fifoclock/hardware/README.md

# FIFO Hardware
KiCAD Schematics, Footprints, PCB files, and LCSC BOM.

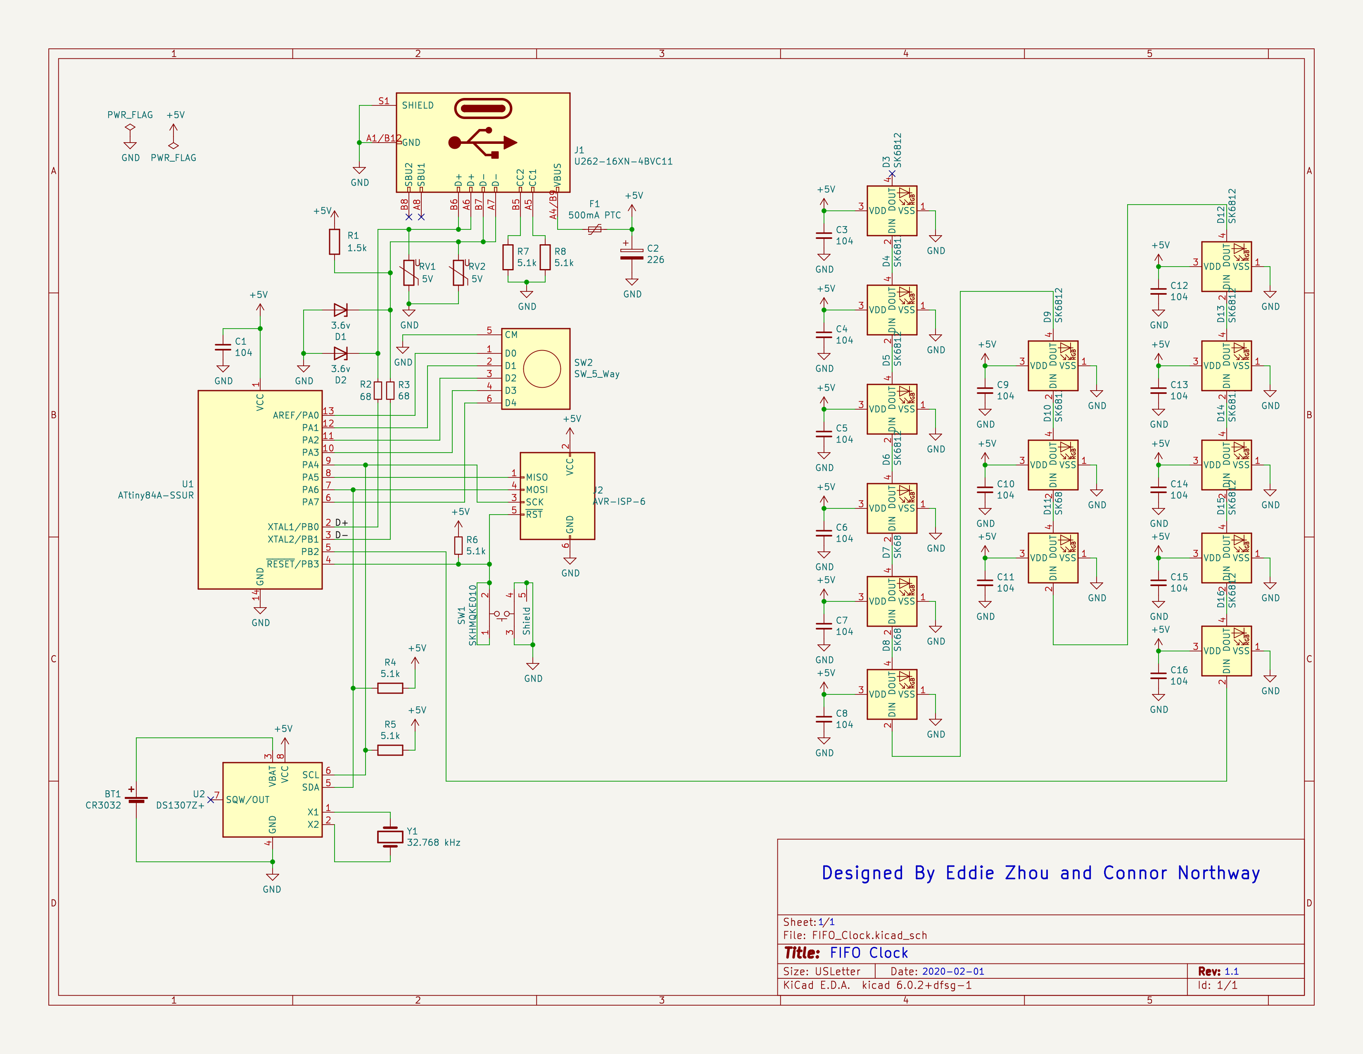
[picture p1: fifo-sch.png]
Preview of Schematic
