fifoclock/hardware/LCSC_BOM.xlsx

LCSC Part Number | Manufacture Part Number | Manufacturer | Customer NO. | Package | Description | RoHS | Order Qty. | Min\Mult Order Qty. | Unit Price | Order Price
C1590 | CL10B104KA8NNNC | Samsung Electro-Mechanics |  | 0603 | Multilayer Ceramic Capacitors MLCC - SMD/SMT 100nF 25V 0603 RoHS | Yes | 200 | 50\50 | $0.0058 | $1.16
C22843 | 0603WAF1501T5E | Uniroyal Elec |  | 0603 | Chip Resistor - Surface Mount 1.5KOhms ±1% 1/10W 0603 RoHS | Yes | 100 | 100\100 | $0.0011 | $0.11
C26000 | 0603WAJ0512T5E | Uniroyal Elec |  | 0603 | Chip Resistor - Surface Mount 5.1KOhms ±5% 1/10W 0603 RoHS | Yes | 100 | 100\100 | $0.0008 | $0.08
C26858 | DS1307ZN+T&R | Maxim Integrated |  | SOP-8_150mil | Real-time Clocks Clock/Calendar I2C, 2-Wire Serial 200uA @ 5V SOP-8_150mil RoHS | Yes | 10 | 1\1 | $0.4423 | $4.43
C27592 | 0603WAF680JT5E | Uniroyal Elec |  | 0603 | Chip Resistor - Surface Mount 68Ohms ±1% 1/10W 0603 RoHS | Yes | 100 | 100\100 | $0.0011 | $0.11
C70376 | BS-2-1 | Q&J |  | DIP | Battery Holders, Clips & Contacts DIP RoHS | Yes | 10 | 10\10 | $0.0573 | $0.58
C92594 | K1-5203UA-01 | Korean Hroparts Elec |  | 7.5mm*7.5mm | 5-way Tactile Switches 7.5mm*7.5mm RoHS | Yes | 10 | 1\1 | $0.3357 | $3.36
C128458 | EEEFK1H220P | PANASONIC |  | SMD,6.3x5.8mm | Aluminum Electrolytic Capacitors - SMD 22uF ±20% 50V SMD,6.3x5.8mm RoHS | Yes | 10 | 5\5 | $0.1050 | $1.05
C202416 | SKHMQKE010 | ALPS Electric |  | SMD | Tactile Switches SPST-NO 6.50mm x 6.20mm 3.10mm 50mA @ 12VDC SMD RoHS | Yes | 10 | 1\1 | $0.1861 | $1.87
C213419 | 1TD125BFNS001 | KDS Daishinku |  | Cylindrical plug2x6 | Radial Cylinder Crystals 32.768KHz ±10ppm Cylindrical plug2x6 RoHS | Yes | 10 | 1\1 | $0.0955 | $0.96
C220597 | ATTINY84A-SSUR | Microchip Tech |  | SOIC-14_150mil | ATMEL & AVR SOIC-14_150mil RoHS | Yes | 10 | 1\1 | $0.8130 | $8.13
C269102 | SMD0805B020TF | Brightking Elec (TAIWAN) |  | 0805 | PTC Resettable Fuses 0805 RoHS | Yes | 10 | 5\5 | $0.0954 | $0.96
C271261 | BZT52C3V6 | Bourne Semicon (Shenzhen) |  | SOD-123 | Zener Diodes SOD-123 RoHS | Yes | 50 | 50\50 | $0.0140 | $0.7
C319148 | U262-161N-4BVC11 | XKB Enterprise |  | SMT | USB Connectors 16 Receptacle 1 SMT RoHS | Yes | 10 | 1\1 | $0.2545 | $2.55
C336566 | EZJZ1V500AA | PANASONIC |  | 0603 | Varistors 5V 0603 RoHS | Yes | 20 | 5\5 | $0.0868 | $1.74
