fifoclock/hardware/FIFO_Clock.kicad_pcb

## KiCad design FIFO_Clock.kicad_pcb (2023-02-17)

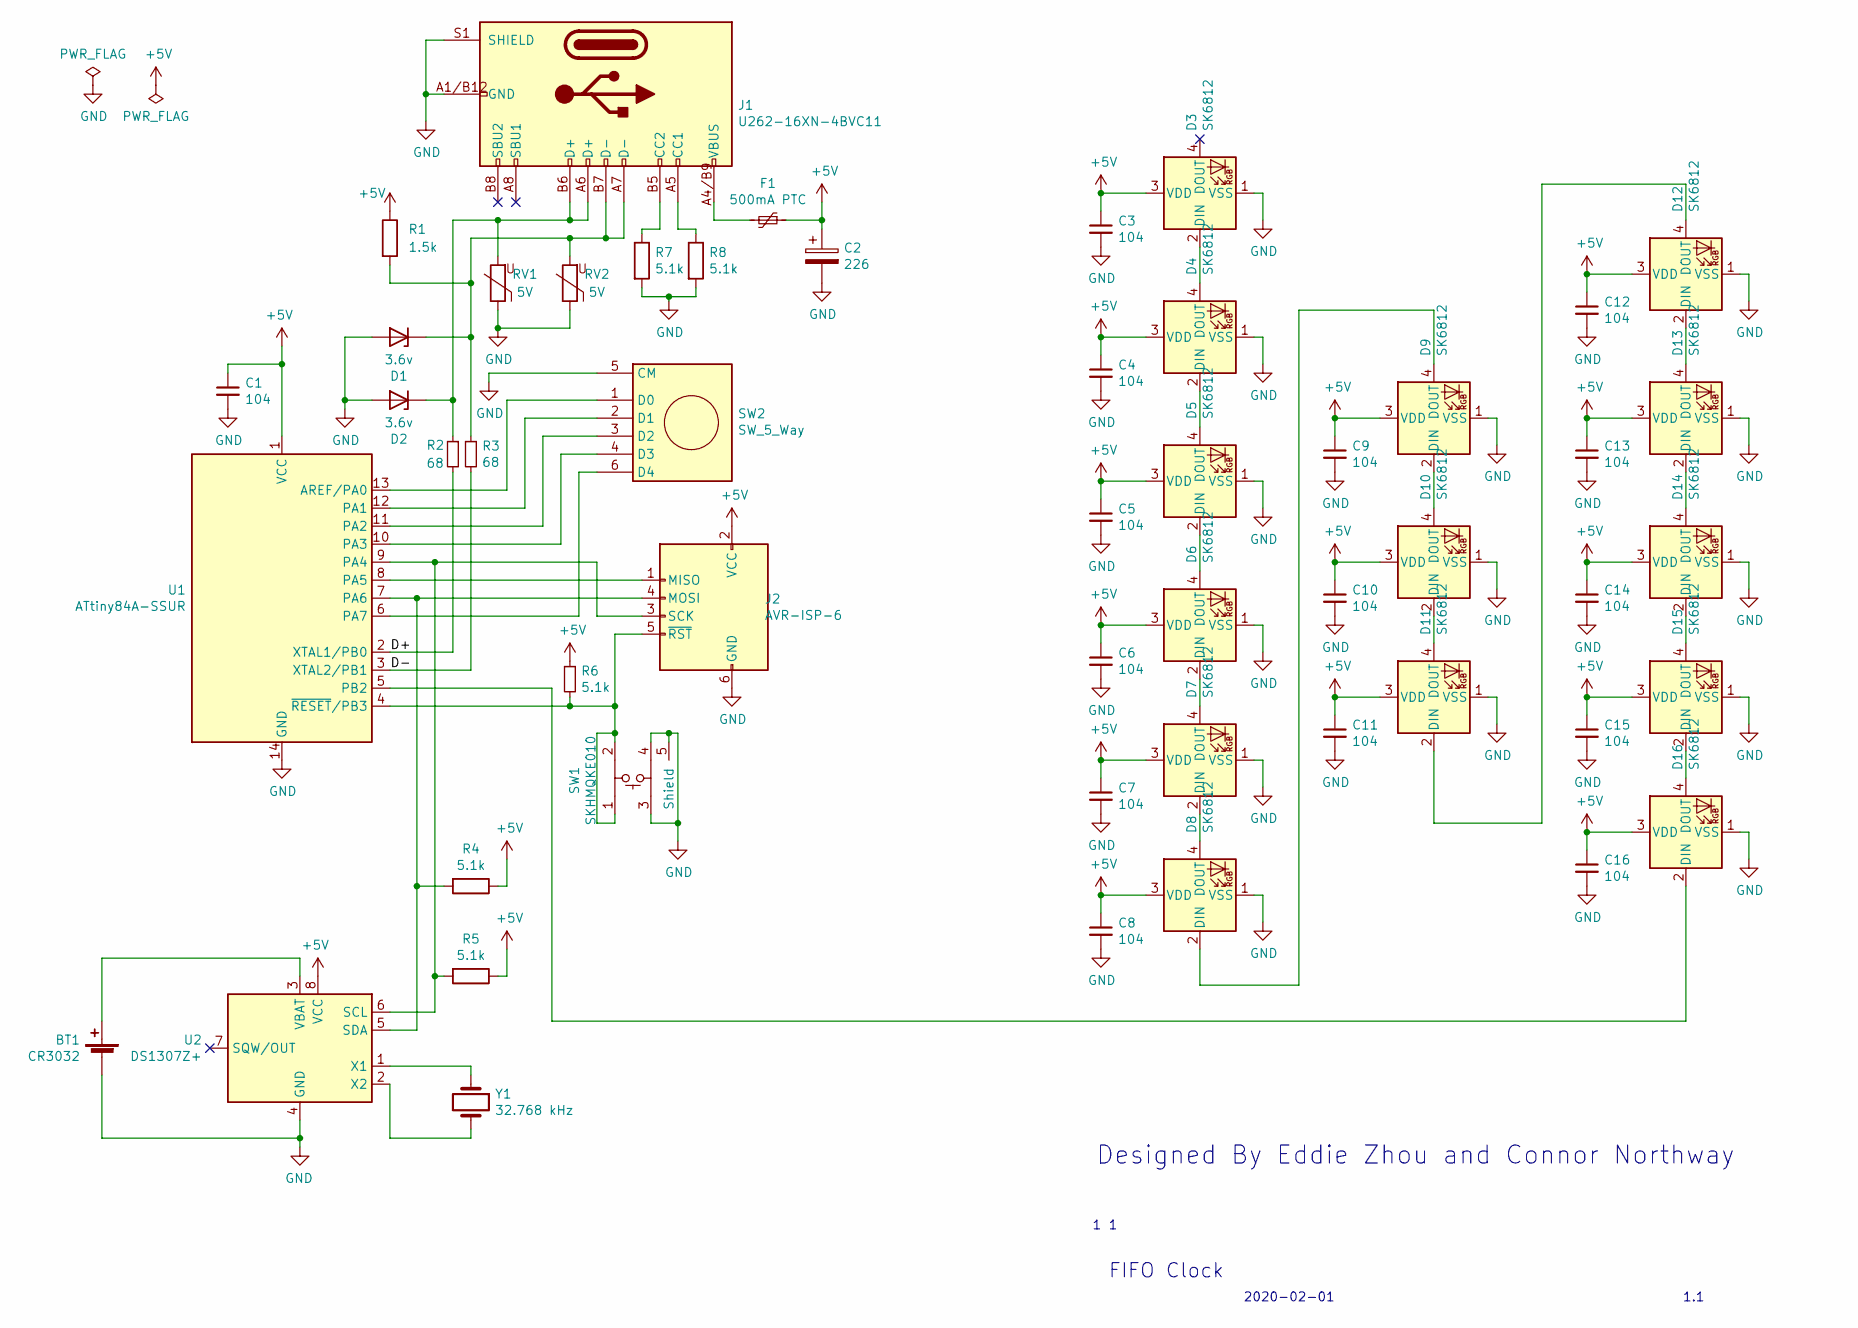
[picture p2: schematic FIFO_Clock.kicad_sch]

Parts:
BT1: CR3032; BS-2-1
C1, C3, C4, C5, C6, C7, C8, C9, C10, C11, C12, C13, C14, C15, C16: 104; C_0603_1608Metric_Pad1.05x0.95mm_HandSolder
C2: 226; CP_Elec_6.3x5.8
D1, D2: 3.6v; D_SOD-123
D3, D4, D5, D6, D7, D8, D9, D10, D11, D12, D13, D14, D15, D16: SK6812; LED_SK6812_PLCC4_5.0x5.0mm_P3.2mm_STEALTH
F1: 500mA PTC; Fuse_0805_2012Metric
J1: U262-16XN-4BVC11
J2: AVR-ISP-6; PinHeader_2x03_P2.54mm_Vertical
R1: 1.5k; R_0603_1608Metric_Pad1.05x0.95mm_HandSolder
R2, R3: 68; R_0603_1608Metric_Pad1.05x0.95mm_HandSolder
R4, R5, R6, R7, R8: 5.1k; R_0603_1608Metric_Pad1.05x0.95mm_HandSolder
RV1, RV2: 5V; R_0603_1608Metric_Pad1.05x0.95mm_HandSolder
SW1: SKHMQKE010
SW2: SW_5_Way; K1-5203UA-01
U1: ATtiny84A-SSUR; SOIC-14_3.9x8.7mm_P1.27mm
U2: DS1307Z+; SOIC-8_3.9x4.9mm_P1.27mm
Y1: 32.768 kHz; Crystal_DS26_D2.0mm_L6.0mm_Horizontal

Connections:
+5V: C1.1, C2.1, C3.1, C4.1, C5.1, C6.1, C7.1, C8.1, C9.1, C10.1, C11.1, C12.1, C13.1, C14.1, C15.1, C16.1, D3.3 (VDD), D4.3 (VDD), D5.3 (VDD), D6.3 (VDD), D7.3 (VDD), D8.3 (VDD), D9.3 (VDD), D10.3 (VDD), D11.3 (VDD), D12.3 (VDD), D13.3 (VDD), D14.3 (VDD), D15.3 (VDD), D16.3 (VDD), F1.1, J2.2 (VCC), R1.1, R4.1, R5.1, R6.1, U1.1 (VCC), U2.8 (VCC)
/D+: R2.2, U1.2 (XTAL1/PB0)
/D-: R3.2, U1.3 (XTAL2/PB1)
GND: BT1.2 (-), C1.2, C2.2, C3.2, C4.2, C5.2, C6.2, C7.2, C8.2, C9.2, C10.2, C11.2, C12.2, C13.2, C14.2, C15.2, C16.2, D1.2 (A), D2.2 (A), D3.1 (VSS), D4.1 (VSS), D5.1 (VSS), D6.1 (VSS), D7.1 (VSS), D8.1 (VSS), D9.1 (VSS), D10.1 (VSS), D11.1 (VSS), D12.1 (VSS), D13.1 (VSS), D14.1 (VSS), D15.1 (VSS), D16.1 (VSS), J1.A1/B12 (GND), J1.A12/B1 (GND), J1.S1 (SHIELD), J2.6 (GND), R7.2, R8.2, RV1.1, RV2.1, SW1.3, SW1.4, SW1.5 (Shield), SW2.5 (CM), U1.14 (GND), U2.4 (GND)
unnamed: BT1.1 (+), U2.3 (VBAT)
unnamed: D1.1 (K), J1.A7 (D-), J1.B7 (D-), R1.2, R3.1, RV2.2
unnamed: D2.1 (K), J1.A6 (D+), J1.B6 (D+), R2.1, RV1.2
unnamed: D3.2 (DIN), D4.4 (DOUT)
unnamed: D4.2 (DIN), D5.4 (DOUT)
unnamed: D5.2 (DIN), D6.4 (DOUT)
unnamed: D6.2 (DIN), D7.4 (DOUT)
unnamed: D7.2 (DIN), D8.4 (DOUT)
unnamed: D8.2 (DIN), D9.4 (DOUT)
unnamed: D10.2 (DIN), D11.4 (DOUT)
unnamed: D9.2 (DIN), D10.4 (DOUT)
unnamed: D11.2 (DIN), D12.4 (DOUT)
unnamed: D12.2 (DIN), D13.4 (DOUT)
unnamed: D13.2 (DIN), D14.4 (DOUT)
unnamed: D14.2 (DIN), D15.4 (DOUT)
unnamed: D15.2 (DIN), D16.4 (DOUT)
unnamed: D16.2 (DIN), U1.5 (PB2)
unnamed: F1.2, J1.A4/B9 (VBUS), J1.A9/B4 (VBUS)
unnamed: J1.A5 (CC1), R8.1
unnamed: J1.B5 (CC2), R7.1
unnamed: J2.1 (MISO), U1.8 (PA5)
unnamed: J2.3 (SCK), R5.2, U1.9 (PA4), U2.6 (SCL)
unnamed: J2.4 (MOSI), R4.2, U1.7 (PA6), U2.5 (SDA)
unnamed: J2.5 (~RST), R6.2, SW1.1, SW1.2, U1.4 (~RESET/PB3)
unnamed: SW2.1 (D0), U1.13 (AREF/PA0)
unnamed: SW2.2 (D1), U1.12 (PA1)
unnamed: SW2.3 (D2), U1.11 (PA2)
unnamed: SW2.4 (D3), U1.10 (PA3)
unnamed: SW2.6 (D4), U1.6 (PA7)
unnamed: U2.1 (X1), Y1.1
unnamed: U2.2 (X2), Y1.2

Notes on the sheet:
FIFO Clock
2020-02-01
Designed By Eddie Zhou and Connor Northway
1.1

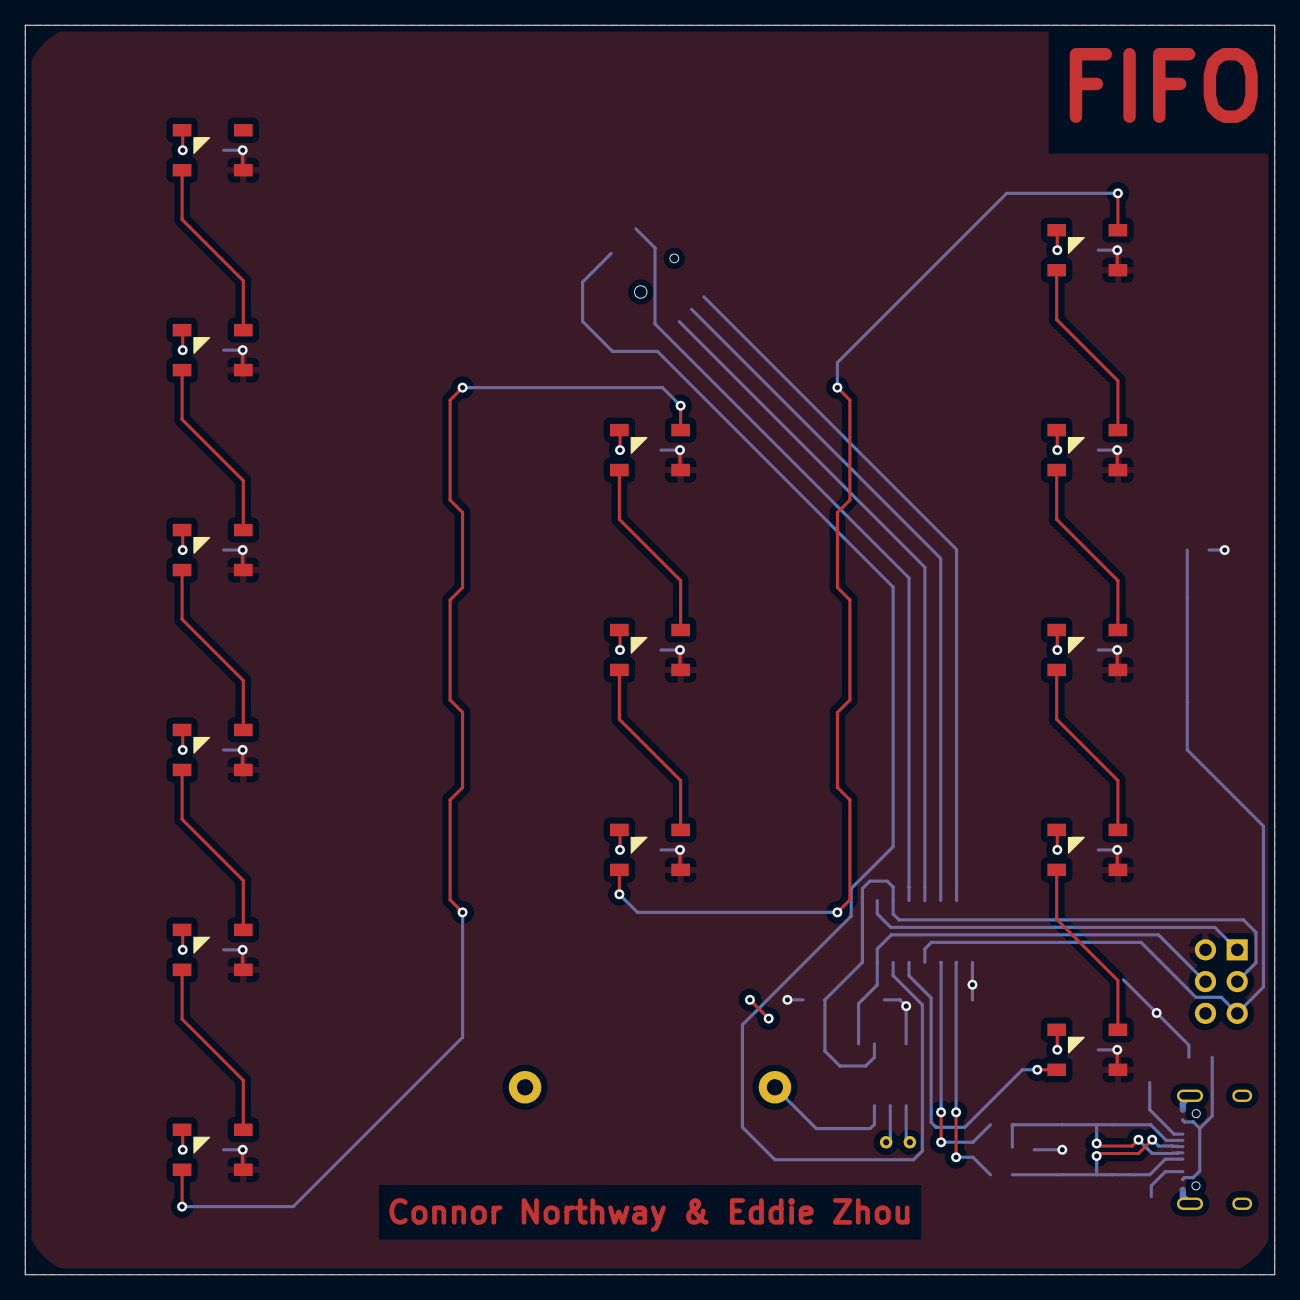
[picture p3: board FIFO_Clock.kicad_pcb from above]

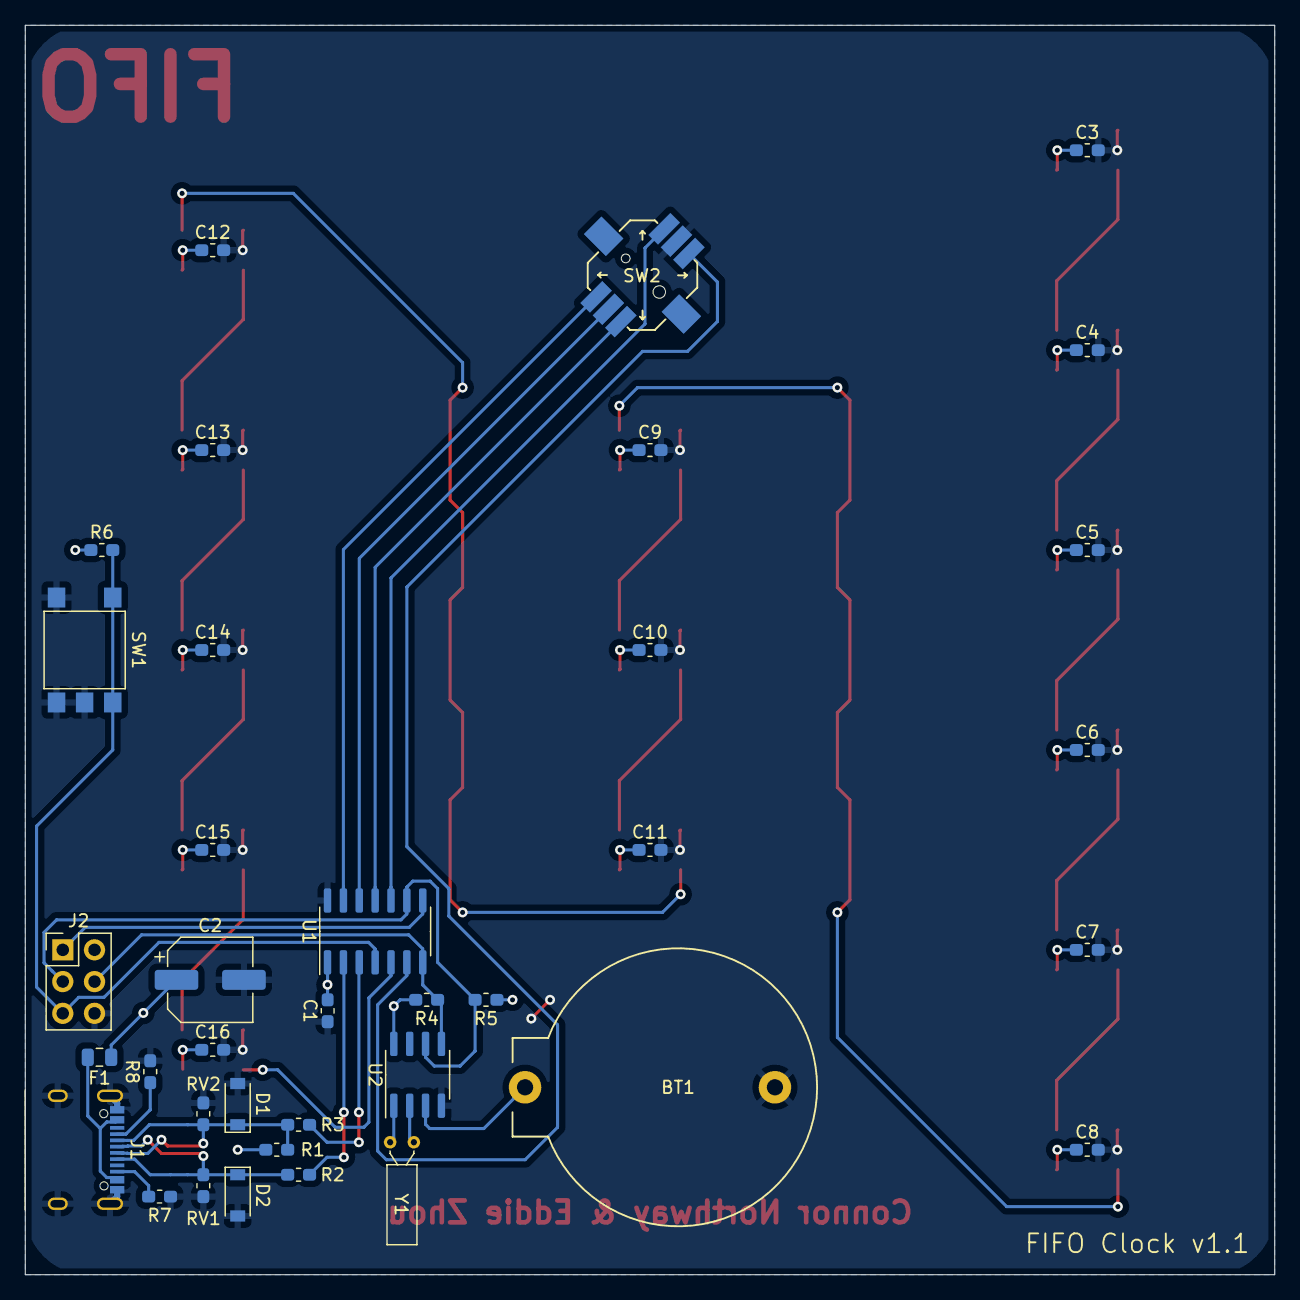
[picture p4: board FIFO_Clock.kicad_pcb from below]

Board: 2 copper layers, 100.0 x 100.0 mm, 51 parts (37 on the bottom side), 35 nets.
