fifoclock/hardware/(commit log)

2019-04-05 initial commit / move to github from google drive
    [LED_Bar_Clock.kicad_pcb, LED_Bar_Clock.sch]
2019-04-13 Finalize USB and Power, and update LED layout
    - add usb circuitry
    - esd protection w/ varistors
    - logic level shifting w/ zener diodes
    - usb protocol pullup/down resistors
    - usb series data resistors
    - update LED layout (now 6-3-5)
    - power PTC fuse
    [LED_Bar_Clock.sch]
2019-04-15 modify resistor values
    changed i2c and reset pullups to 5.1k to match usb cc pulldown.
    allows for easier sourcing of parts
    [LED_Bar_Clock.sch]
2019-04-15 reverse direction of zener diodes
    v-usb spec has them pointing away from ground:
    http://vusb.wikidot.com/hardware
    [LED_Bar_Clock.sch]
2019-04-22 Add type-c footprint
    also initialize footprint library for future footprints
2019-04-23 use core libraries for type c connector symbol
    Some files seem to have changed format due to the change between
    5.0.0 and 5.1.0 of KiCad. This is reflected in this commit
    [LED_Bar_Clock.sch]
2019-04-23 add annotations and power flags
    [LED_Bar_Clock.sch]
2019-04-23 update type c receptacle footprint
    add silkscreen line for front of connector
    move silkscreen reference and fab reference
2019-04-23 initial commit of alps switch footprint
2019-04-25 fix pin numbering of SKHMQKE010
2019-04-26 add BS-2-1 battery holder
    - estimation of silkscreen because datasheet is badly dimensioned
    (trig and rounding was involved)
    - courtyard for added safety in case it's a few parts of a mm off
    - unknown if pins are correctly numbered yet
2019-04-26 fix overlapping silkscreen w/ copper in BS-2-1 footprint
2019-04-28 Add 5-way switch footprint
    pin 5 is ground
2019-04-29 change reset switch in schematic
    [LED_Bar_Clock.sch]
2019-04-29 Fix 5 way switch symbol pin labels
2019-04-29 Delete extra i2c junction
    Hopefully I didn't break anything with the project component library
    [LED_Bar_Clock.sch]
2019-04-29 Change duplicate pin 5 to pin 6 on 5-way switch
    [LED_Bar_Clock.sch]
2019-04-29 assign footprints and create netlist
    also remove netlist from .gitignore
    [LED_Bar_Clock.sch]
2019-04-30 fix usb c connector by stacking redundant pads
    also update netlist
2019-04-30 Create custom symbol for usb receptacle
    [LED_Bar_Clock.sch]
2019-04-30 annotate usb receptacle and regen netlist
    [LED_Bar_Clock.sch]
2019-04-30 fix 5-way switch pads
    the pads did not have their origin at the center which makes
    connecting traces extremely difficult. moved the origin of each
    pad to the center of the pad
2019-04-30 begin pcb layout
    - basic layout of LEDs, usb conn, battery, etc
    - battery may interfere with future mounting hole
    - traces between LEDs and between LEDs and caps
    - general idea of where to place passives around usb conn.
    - began routing between attiny, switch, battery and rtc
    - likely too eager, feel free to rip up. Will likely need to
    change because of mounting hole, also may be inefficient
    - General ideas for routing:
    - default trace width should be fine if we stay under 500ma (.25 mm)
    - manhattan routing may be a good idea, saw it somewhere
    - fill on top for 5v, on bottom for ground (or other way around)?
    - not sure if this would solve or create issues
    - some areas ne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
    [LED_Bar_Clock.kicad_pcb]
2019-04-30 fix smd pads in type c receptacle footprint
2019-04-30 Create 2 sided SMD design (only LEDs on front)
    [LED_Bar_Clock_2_Side_SMD.kicad_pcb]
2019-04-30 Add LCSC BOM
    [LCSC_BOM.xlsx]
2019-04-30 Add B side usb data lines
    [LED_Bar_Clock_2_Side_SMD.kicad_pcb]
2019-04-30 Flip crystal footprint
    [LED_Bar_Clock_2_Side_SMD.kicad_pcb]
2019-05-01 an attempt at better placement for right edge
    (icsp header, switches, power circuitry)
    [LED_Bar_Clock_2_Side_SMD.kicad_pcb]
2019-05-02 Finish pcb routing
    [LED_Bar_Clock.sch, LED_Bar_Clock_2_Side_SMD.kicad_pcb]
2019-05-02 Fix led and trace alignment
    [LED_Bar_Clock_2_Side_SMD.kicad_pcb]
2019-05-02 Center 5 way switch
    [LED_Bar_Clock_2_Side_SMD.kicad_pcb]
2019-05-02 Refresh fills
    [LED_Bar_Clock_2_Side_SMD.kicad_pcb]
2019-05-02 fix annotations and silkscreen locations
    [LED_Bar_Clock.sch, LED_Bar_Clock_2_Side_SMD.kicad_pcb]
2019-05-02 fix copper pour
    [LED_Bar_Clock_2_Side_SMD.kicad_pcb]
2019-05-03 silkscreen and stealth labels
    add a stealth footprint for the leds because we dont need silkscreen
    on the front
    official name is FILO Clock
    first illuminated last out
    .. or ..
    first ignited last out
    [LED_Bar_Clock.sch, LED_Bar_Clock_2_Side_SMD.kicad_pcb]
2019-05-03 create gerber files for manufacturing
    [LED_Bar_Clock_2_Side_SMD-B_Cu.gbr, LED_Bar_Clock_2_Side_SMD-B_Mask.gbr, LED_Bar_Clock_2_Side_SMD-B_Paste.gbr, LED_Bar_Clock_2_Side_SMD-B_SilkS.gbr, LED_Bar_Clock_2_Side_SMD-Edge_Cuts.gbr, LED_Bar_Clock_2_Side_SMD-F_Cu.gbr, LED_Bar_Clock_2_Side_SMD-F_Mask.gbr, LED_Bar_Clock_2_Side_SMD-F_Paste.gbr]
2019-05-06 Remove unused kicad pcb layout
    [LED_Bar_Clock.kicad_pcb]
2019-05-06 Rename pcb layout to match project
    [LED_Bar_Clock.kicad_pcb]
2019-05-06 Remove unused KiCAD project file
2019-06-03 Update BOM to match final order
    [LCSC_BOM.xlsx]
2019-06-03 Rename KiCAD project to FILO_Clock
    [FILO_Clock.kicad_pcb, FILO_Clock.sch]
2020-01-13 v1.1 changes transferred, FILO->FIFO change
    [FIFO_Clock.kicad_pcb, FIFO_Clock.sch]
2020-02-01 change schematic to US letter, add image to README
    [FIFO_Clock.sch]
2020-02-01 update gerbers to v1.1
    [FIFO_Clock-B_Cu.gbr, FIFO_Clock-B_Mask.gbr, FIFO_Clock-B_Paste.gbr, FIFO_Clock-B_SilkS.gbr, FIFO_Clock-Edge_Cuts.gbr, FIFO_Clock-F_Cu.gbr, FIFO_Clock-F_Mask.gbr, FIFO_Clock-F_Paste.gbr]
2023-02-17 Fix usb CC pulldown circuit
    make sure to use two pulldown resistors instead of shorting CC lines
    found this while trying to repurpose one of the old pcbs for something else
    <x> years later I have a slightly better understanding of the USB spec..
    [FIFO_Clock.kicad_pcb, FIFO_Clock.kicad_sch, FIFO_Clock.sch]
2023-02-17 remove gerbers
    out of date, and it's better to not have generated outputs in the repo anyway
    [FIFO_Clock-B_Cu.gbr, FIFO_Clock-B_Mask.gbr, FIFO_Clock-B_Paste.gbr, FIFO_Clock-B_SilkS.gbr, FIFO_Clock-Edge_Cuts.gbr, FIFO_Clock-F_Cu.gbr, FIFO_Clock-F_Mask.gbr, FIFO_Clock-F_Paste.gbr]
